xhmkggybzwmz/riscV_DSP_EMG/firmware/stm32/emg_acquisition/Core/Inc/main.h

#define EMG_SPI_CS_Pin          GPIO_PIN_4
#define EMG_SPI_CS_GPIO_Port    GPIOA
#define EMG_SPI_READY_Pin       GPIO_PIN_6
#define EMG_SPI_READY_GPIO_Port GPIOA
