xhmkggybzwmz/riscV_DSP_EMG/rtl/infer/emg_cnn.v

`timescale 1ns / 1ps
`default_nettype none

`include "esi_defs.vh"

// emg_cnn - INT8 streaming 1D-CNN inference core (E3b), ESI v1 POST_DSP input.
// Integer semantics: docs/ml/e2_fixed_point_spec.md section 4 (golden model reference/emg_fixed/cnn/int_model.py).
//
//   Conv1 N_CH->C1 k K1 s S1 : int16 x int8 ; Conv2 C1->C2 k K2 s S2 ; Conv3 C2->C3 k K3 s S3 : uint8 x int8
//   acc = bias + sum w*x (int32) ; a = acc <= 0 ? 0 : min(255, (acc*M + 2^(s-1)) >> s)   (uint8)
//   GAP: running sum of the last MGAP conv3 outputs (add new, subtract the one leaving)
//   FC : score[k] = fcb[k] + sum_c fcw[k][c] * gsum[c] (int32) ; argmax, ties -> lowest index
//   decision schedule: conv3 step j = FIRST + EVERY*n, FIRST = (SETTLE + WINDOW - RF)/D (SETTLE = 0 ->
//   first decision at sample index 399 after SOS/GAP), EVERY = STEP/D.
//
// Micro-architecture (P = 1): one MAC pipeline (issue -> registered weight/activation read ->
// registered multiply -> int32 accumulate), time-multiplexed over all layers. Each accepted frame
// writes one sample into the conv1 line buffer and runs the layers that become due (at most
// conv1 -> conv2 -> conv3 -> FC). s_tready is low while a frame is being processed.
// SOS/GAP: all counters, stride phases, buffer heads, the GAP ring and sums are cleared before the
// frame is used as sample 0. The dbg_* port emits every accumulator / activation / GAP sum / score.

module emg_cnn #(
    parameter N_CH = 4,
    parameter C1 = 16, parameter K1 = 8, parameter S1 = 2,
    parameter C2 = 32, parameter K2 = 7, parameter S2 = 2,
    parameter C3 = 32, parameter K3 = 6, parameter S3 = 5,
    parameter NCLS = 6, parameter MGAP = 19,
    parameter WINDOW = 400, parameter STEP = 100, parameter SETTLE = 0,
    parameter W1_FILE = "", parameter B1_FILE = "", parameter M1_FILE = "", parameter SH1_FILE = "",
    parameter W2_FILE = "", parameter B2_FILE = "", parameter M2_FILE = "", parameter SH2_FILE = "",
    parameter W3_FILE = "", parameter B3_FILE = "", parameter M3_FILE = "", parameter SH3_FILE = "",
    parameter FCW_FILE = "", parameter FCB_FILE = ""
) (
    input  wire                 clk,
    input  wire                 rst,

    input  wire                 s_tvalid,
    output wire                 s_tready,
    input  wire [127:0]         s_tdata,
    input  wire [79:0]          s_tuser,
    input  wire                 s_tlast,

    output wire                 res_valid,            // = res_valid_r & ~rst
    input  wire                 res_ready,
    output reg  [NCLS*32-1:0]   res_scores,
    output reg  [3:0]           res_argmax,
    output reg  [31:0]          res_end,          // sample index (since SOS/GAP) of the window end
    output reg  [31:0]          res_seq,
    output reg  [31:0]          res_ts,
    output reg  [7:0]           res_seg,
    output reg  [31:0]          res_count,
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
